zainahm3d/PDSupply-Solo-PCB/Front Render.png

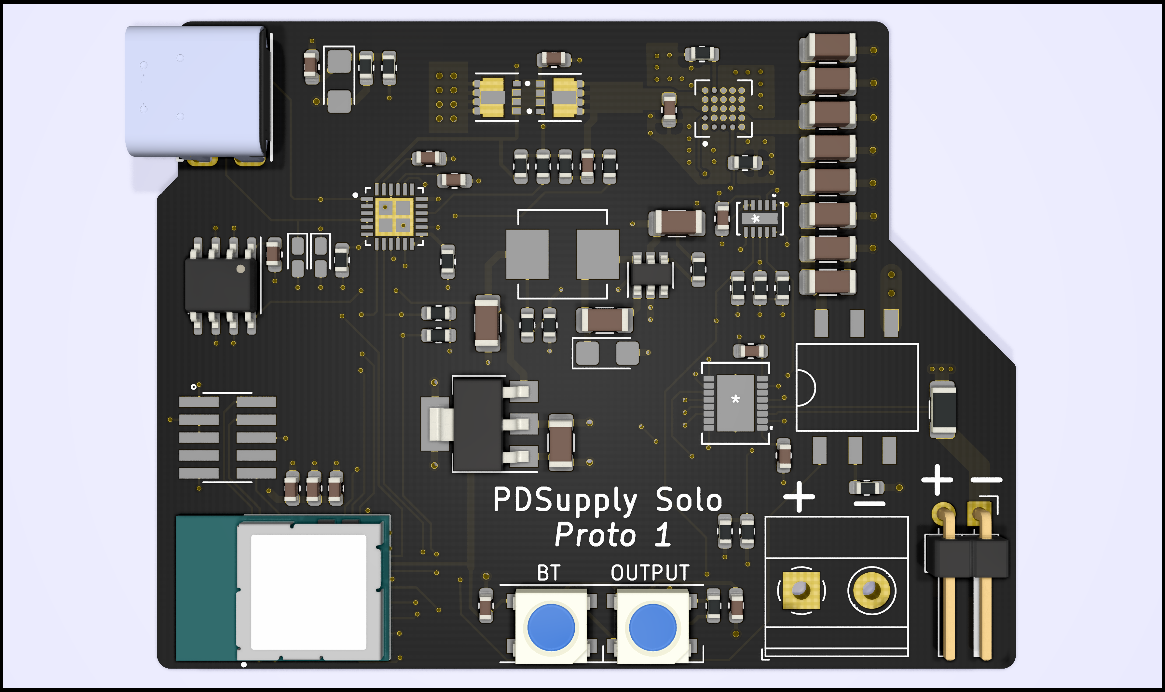
Front Render.png
