zainahm3d/PDSupply-Solo-PCB/Components/2020-05-08_21-34-57/NHR_16.step

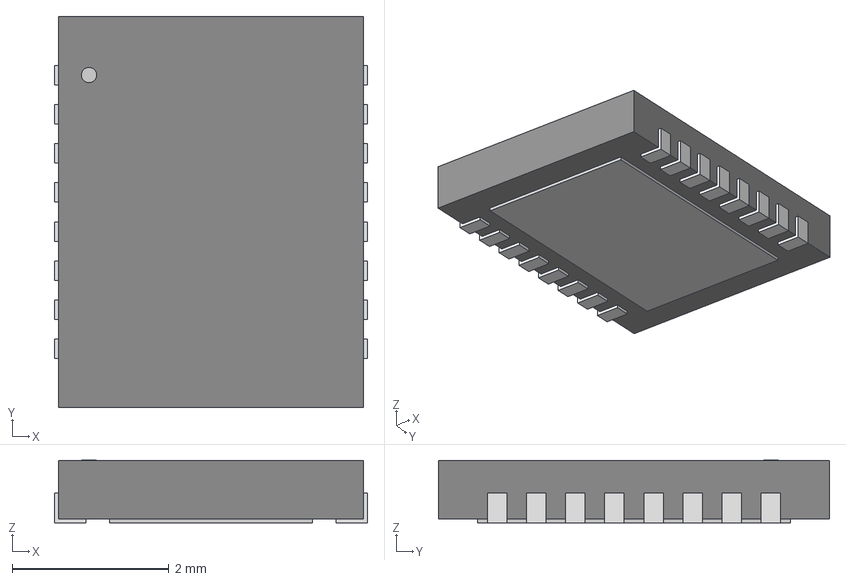
[picture p2: CAD file, 2020-06-15]
Components/2020-05-08_21-34-57/NHR_16.step
4.00 x 5.00 x 0.803 mm
