zainahm3d/PDSupply-Solo-PCB/Components/AQV252GAX/AQV252G2S_PAN-L.step

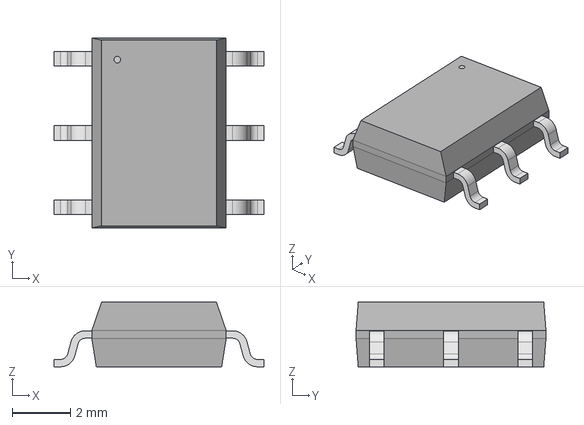
[picture p3: CAD file, 2020-06-15]
Components/AQV252GAX/AQV252G2S_PAN-L.step
7.19 x 6.50 x 2.21 mm
