zainahm3d/PDSupply-Solo-PCB/Components/FTSH-105-01-L-DV-K/FTSH-105-01-L-DV-K.stp

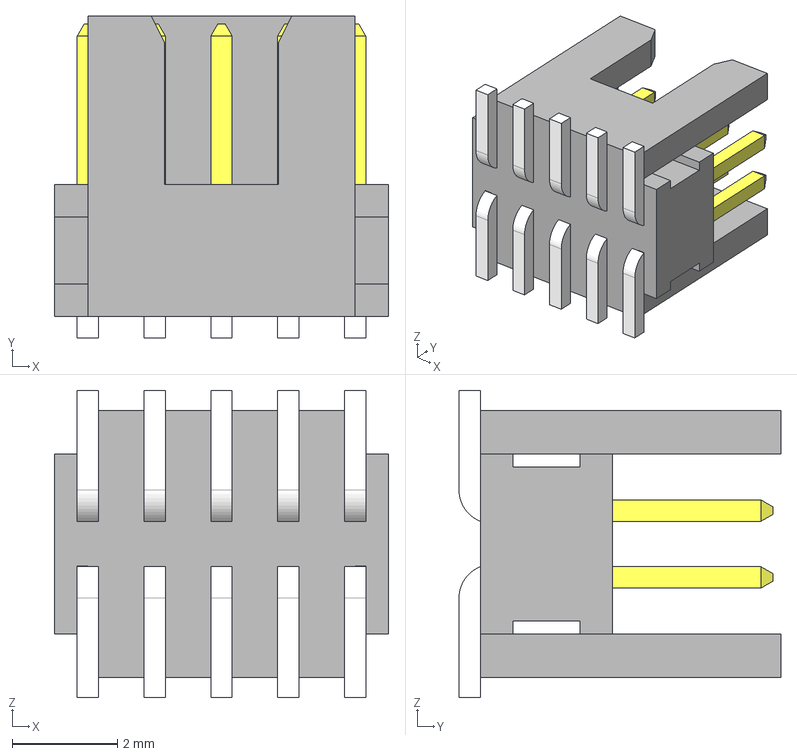
[picture p4: CAD file, 2020-06-15]
Components/FTSH-105-01-L-DV-K/FTSH-105-01-L-DV-K.stp
6.35 x 6.12 x 5.84 mm
_FTSH-105-01-L-DV-K_body
_FTSH-105-01-L-DV-K_pins1
_FTSH-105-01-L-DV-K_pins2
