zainahm3d/PDSupply-Solo-PCB/Components/LTC2644CMS-L10_PBF/MSOP-12_MS_LIT.step

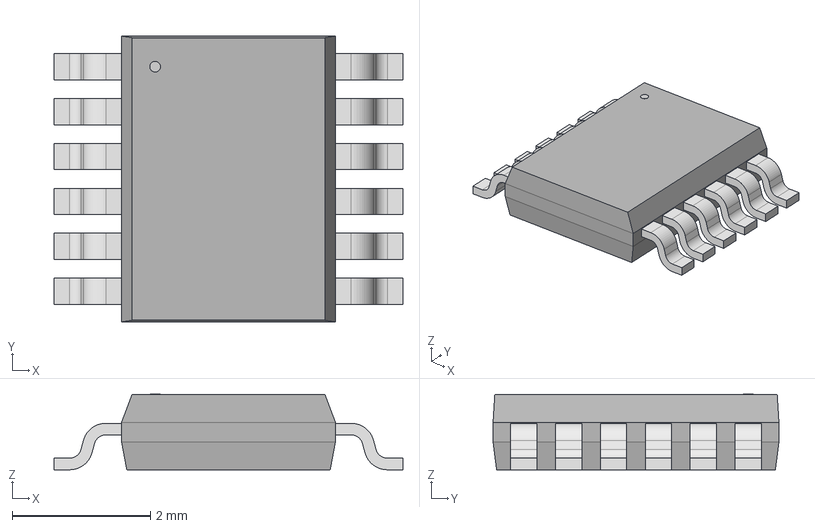
[picture p5: CAD file, 2020-06-15]
Components/LTC2644CMS-L10_PBF/MSOP-12_MS_LIT.step
5.05 x 4.14 x 1.09 mm
