zainahm3d/PDSupply-Solo-PCB/Components/LTM8074IY_PBF/BGA25_A.step

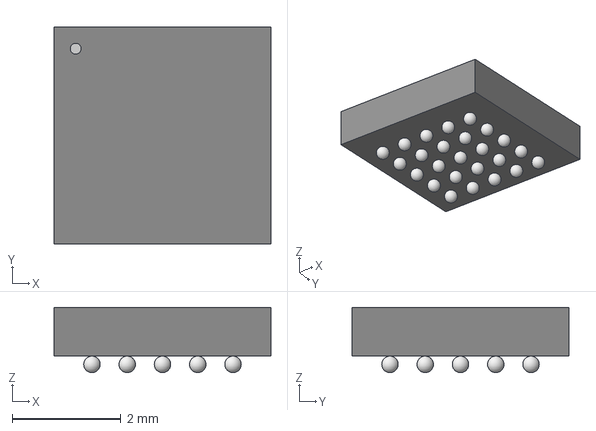
[picture p6: CAD file, 2020-06-15]
Components/LTM8074IY_PBF/BGA25_A.step
4.00 x 4.00 x 1.20 mm
