zainahm3d/PDSupply-Solo-PCB/Components/STUSB4500QTR/QFN24EP_4X4_STM.step

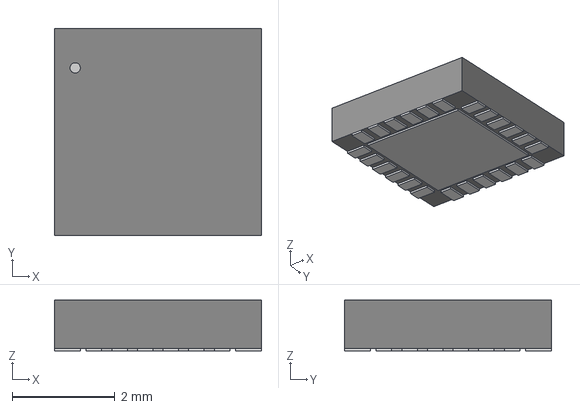
[picture p7: CAD file, 2020-06-15]
Components/STUSB4500QTR/QFN24EP_4X4_STM.step
4.04 x 4.04 x 0.993 mm
