zainahm3d/PDSupply-Solo-PCB/Components/ul_LTC3886EUKGPBF/2020-03-23_19-06-35/STEP/UKG_52-M.step

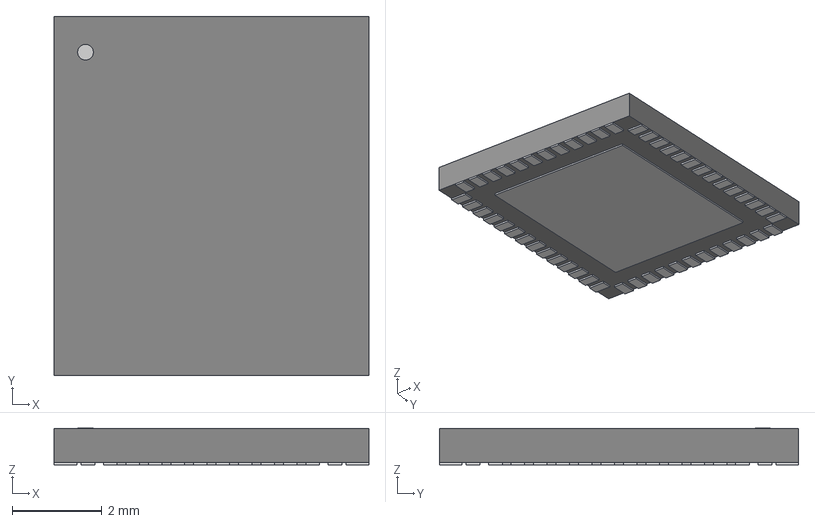
[picture p8: CAD file, 2020-03-23]
Components/ul_LTC3886EUKGPBF/2020-03-23_19-06-35/STEP/UKG_52-M.step
7.01 x 8.00 x 0.815 mm
