zainahm3d/PDSupply-Solo-PCB/(list of files, cad)

Other CAD files:
Components/ul_LTC3886EUKGPBF/2020-03-23_19-06-35/STEP/UKG_52.step
Components/ul_LTC3886EUKGPBF/2020-03-23_19-06-35/STEP/UKG_52-L.step
