zainahm3d/PDSupply-Solo-PCB/PD_PowerSupply.kicad_pcb

## KiCad design PD_PowerSupply.kicad_pcb (2022-03-03)

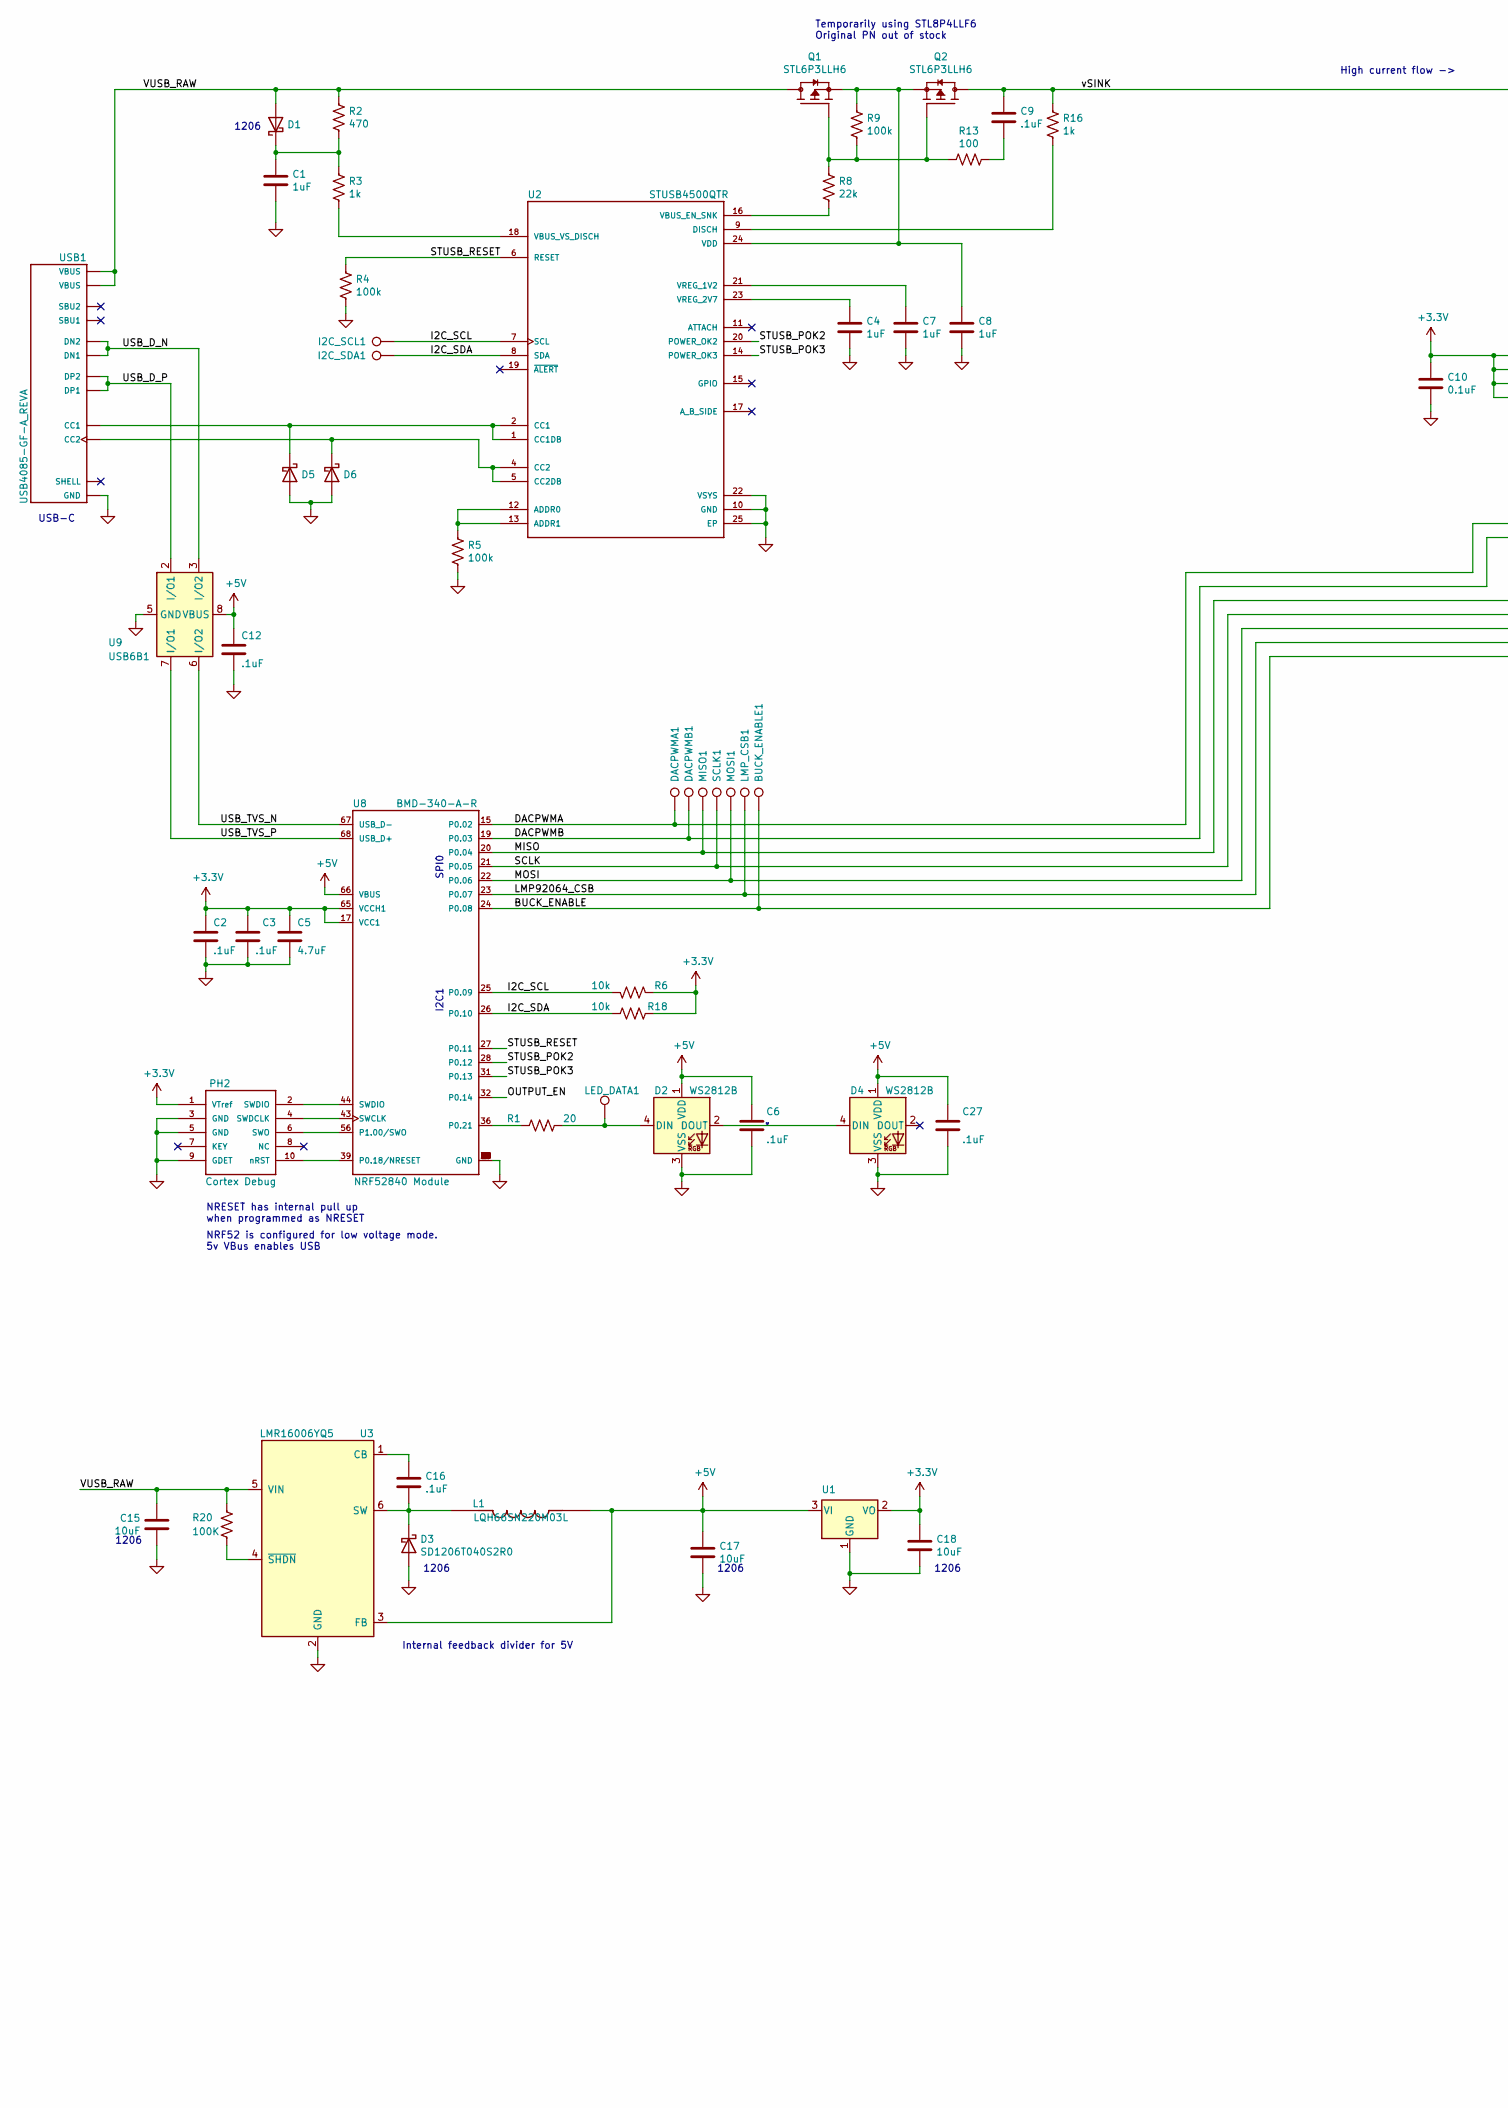
[picture p9: schematic PD_PowerSupply.sch, USB PD Power Supply, part in row 1, column 1]

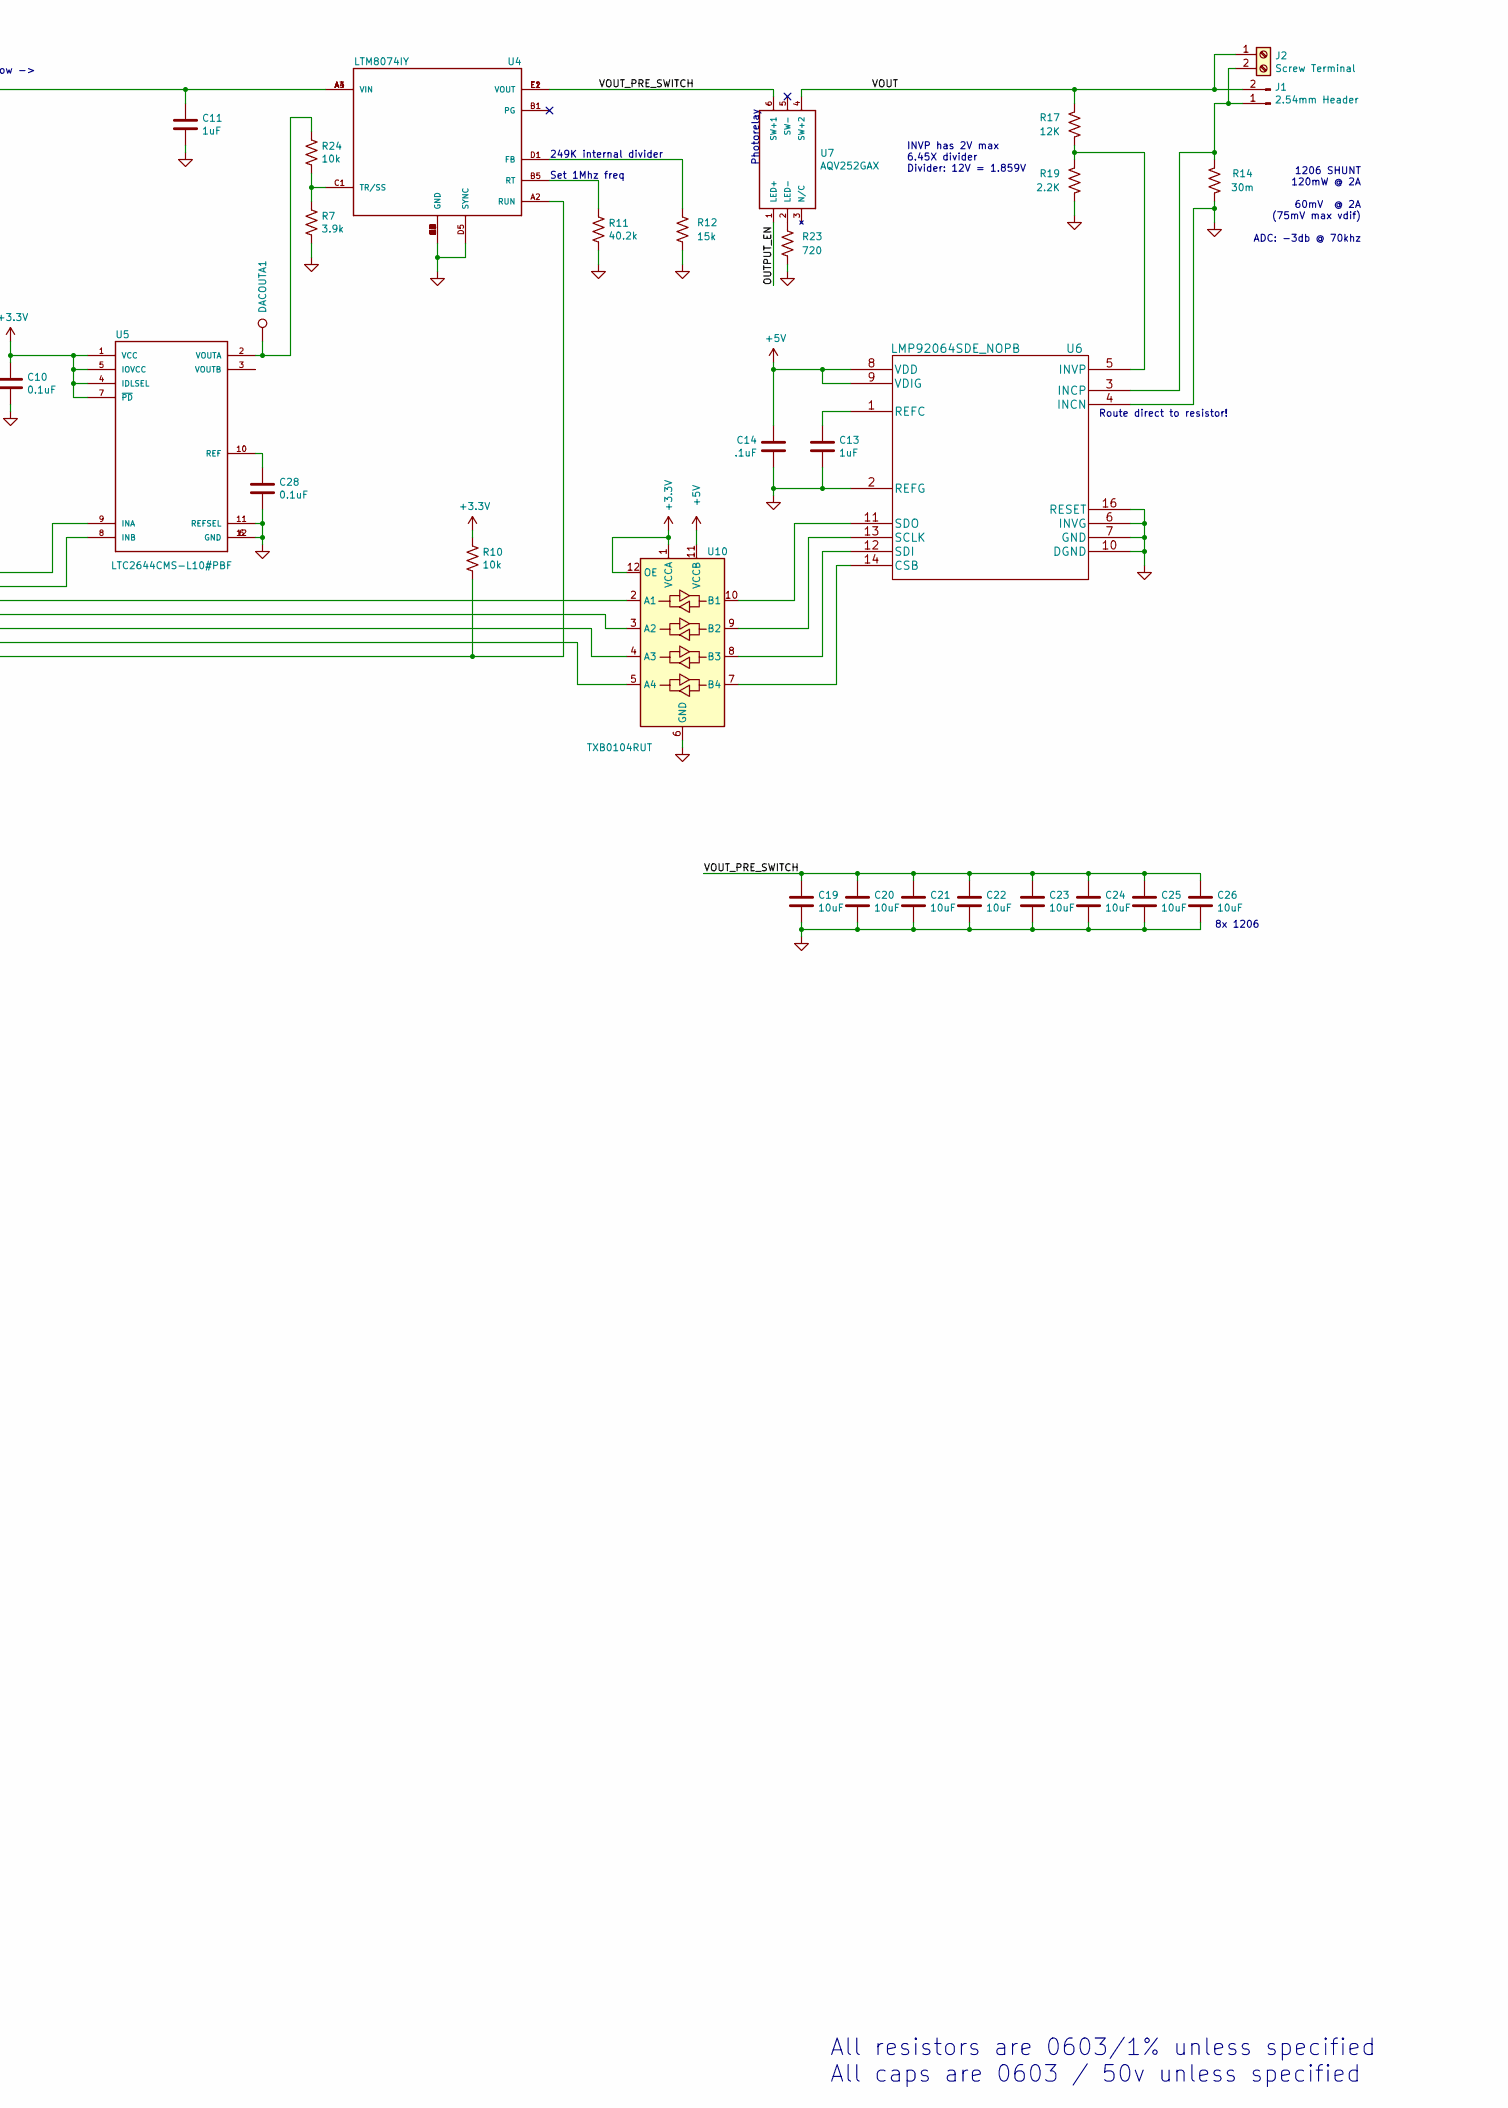
[picture p10: schematic PD_PowerSupply.sch, USB PD Power Supply, part in row 1, column 2]

Parts:
BUCK_ENABLE1: TestPoint; TestPoint_Pad_D1.0mm
C1, C4, C7, C8, C11, C13: 1uF; C_0603_1608Metric
C2, C3, C6, C9, C12, C14, C27: .1uF; C_0603_1608Metric
C5: 4.7uF; C_0603_1608Metric
C10, C28: 0.1uF; C_0603_1608Metric
C15, C17, C18, C19, C20, C21, C22, C23, C24, C25, C26: 10uF; C_1206_3216Metric
C16: .1uF; C_1206_3216Metric
D1: D_Schottky; D_1206_3216Metric_Castellated
D2, D4: WS2812B; LED_WS2812B_PLCC4_5.0x5.0mm_P3.2mm
D3: SD1206T040S2R0; D_1206_3216Metric_Castellated
D5, D6: D_Schottky; D_0603_1608Metric_Castellated
DACOUTA1: TestPoint; TestPoint_Pad_D1.0mm
DACPWMA1: TestPoint; TestPoint_Pad_D1.0mm
DACPWMB1: TestPoint; TestPoint_Pad_D1.0mm
I2C_SCL1, I2C_SDA1: TestPoint; TestPoint_Pad_D1.0mm
J1: 2.54mm Header; PinHeader_1x02_P2.54mm_Horizontal
J2: Screw Terminal; TerminalBlock_Phoenix_MKDS-1,5-2_1x02_P5.00mm_Horizontal
L1: LQH66SN220M03L; IND_LQH66SN220M03L
LED_DATA1: TestPoint; TestPoint_Pad_D1.0mm
LMP_CSB1: TestPoint; TestPoint_Pad_D1.0mm
MISO1: TestPoint; TestPoint_Pad_D1.0mm
MOSI1: TestPoint; TestPoint_Pad_D1.0mm
PH2: FTSH-105-01-L-DV-K; SAMTEC_FTSH-105-01-L-DV-K
Q1, Q2: STL6P3LLH6; TRANS_STL6P3LLH6
R1: 20; R_0603_1608Metric
R2: 470; R_0603_1608Metric
R3, R16: 1k; R_0603_1608Metric
R4, R5, R9: 100k; R_0603_1608Metric
R6, R10, R18, R24: 10k; R_0603_1608Metric
R7: 3.9k; R_0603_1608Metric
R8: 22k; R_0603_1608Metric
R11: 40.2k; R_0603_1608Metric
R12: 15k; R_0603_1608Metric
R13: 100; R_0603_1608Metric
R14: 30m; R_1206_3216Metric
R17: 12K; R_0603_1608Metric
R19: 2.2K; R_0603_1608Metric
R20: 100K; R_0603_1608Metric
R23: 720; R_0603_1608Metric
SCLK1: TestPoint; TestPoint_Pad_D1.0mm
U1: LM1117LD-3.3; SOT-223-3_TabPin2
U2: STUSB4500QTR; QFN50P400X400X90-25N
U3: LMR16006YQ5; SOT-23-6
U4: LTM8074IY; BGA25C65P5X5_400X400X198N
U5: LTC2644CMS-L10#PBF; SOP65P490X110-12N_LTC2644CMS-L10#PBF
U6: LMP92064SDE_NOPB; LMP92064SDE&slash_NOPB
U7: AQV252GAX; SOP6
U8: BMD-340-A-R; RIGADO_BMD-340-A-R
U9: USB6B1; SOIC-8_3.9x4.9mm_P1.27mm
U10: TXB0104RUT; Texas_R_PUQFN-N12
USB1: USB4085-GF-A_REVA; GCT_USB4085-GF-A_REVA

Connections:
+3V3: C2.1, C3.1, C5.1, C10.1, C18.1, PH2.1 (VTref), R6.1, R10.1, R18.1, U1.2 (VO), U5.1 (VCC), U5.4 (IDLSEL), U5.5 (IOVCC), U5.7 (~PD~), U8.17 (VCC1), U8.65 (VCCH1), U10.1 (VCCA), U10.12 (OE)
+5V: C6.1, C12.1, C14.1, C17.1, C27.1, D2.1 (VDD), D4.1 (VDD), L1.2, U1.3 (VI), U3.3 (FB), U6.8 (VDD), U6.9 (VDIG), U8.66 (VBUS), U9.1 (VBUS), U9.8 (VBUS), U10.11 (VCCB)
/BUCK_ENABLE: BUCK_ENABLE1.1, R10.2, U4.A2 (RUN), U8.24 (P0.08)
/DACPWMA: DACPWMA1.1, U5.9 (INA), U8.15 (P0.02)
/DACPWMB: DACPWMB1.1, U5.8 (INB), U8.19 (P0.03)
/I2C_SCL: I2C_SCL1.1, R6.2, U2.7 (SCL), U8.25 (P0.09)
/I2C_SDA: I2C_SDA1.1, R18.2, U2.8 (SDA), U8.26 (P0.10)
/LMP92064_CSB: LMP_CSB1.1, U8.23 (P0.07), U10.5 (A4)
/MISO: MISO1.1, U8.20 (P0.04), U10.2 (A1)
/MOSI: MOSI1.1, U8.22 (P0.06), U10.4 (A3)
/OUTPUT_EN: U7.1 (LED+), U8.32 (P0.14)
/SCLK: SCLK1.1, U8.21 (P0.05), U10.3 (A2)
/STUSB_POK2: U2.20 (POWER_OK2), U8.28 (P0.12)
/STUSB_POK3: U2.14 (POWER_OK3), U8.31 (P0.13)
/STUSB_RESET: R4.1, U2.6 (RESET), U8.27 (P0.11)
/USB_D_N: U9.3 (I/O2), USB1.A7 (DN1), USB1.B7 (DN2)
/USB_D_P: U9.2 (I/O1), USB1.A6 (DP1), USB1.B6 (DP2)
/USB_TVS_N: U8.67 (USB_D-), U9.6 (I/O2)
/USB_TVS_P: U8.68 (USB_D+), U9.7 (I/O1)
/VOUT: J1.2, J2.1, R17.1, U7.4 (SW+2)
/VOUT_PRE_SWITCH: C19.1, C20.1, C21.1, C22.1, C23.1, C24.1, C25.1, C26.1, U4.E1 (VOUT), U4.E2 (VOUT), U7.6 (SW+1)
/VUSB_RAW: C15.2, D1.2 (A), Q1.5_6_7_8 (D), R2.1, R20.1, U3.5 (VIN), USB1.A4 (VBUS), USB1.A9 (VBUS), USB1.B4 (VBUS), USB1.B9 (VBUS)
/vSINK: C9.1, C11.1, Q2.5_6_7_8 (D), R16.2, U4.A3 (VIN), U4.A4 (VIN)
GND: C1.2, C2.2, C3.2, C4.2, C5.2, C6.2, C7.2, C8.2, C10.2, C11.2, C12.2, C13.2, C14.2, C15.1, C17.2, C18.2, C19.2, C20.2, C21.2, C22.2, C23.2, C24.2, C25.2, C26.2, C27.2, C28.2, D2.3 (VSS), D3.2 (A), D4.3 (VSS), D5.2 (A), D6.2 (A), PH2.3 (GND), PH2.5 (GND), PH2.9 (GDET), R4.2, R5.2, R7.2, R11.2, R12.2, R14.2, R19.2, R23.2, U1.1 (GND), U2.10 (GND), U2.22 (VSYS), U2.25 (EP), U3.2 (GND), U4.A1 (GND), U4.A5 (GND), U4.B2 (GND), U4.B3 (GND), U4.B4 (GND), U4.C2 (GND), U4.C3 (GND), U4.C4 (GND), U4.C5 (GND), U4.D2 (GND), U4.D3 (GND), U4.D4 (GND), U4.D5 (SYNC), U4.E3 (GND), U4.E4 (GND), U4.E5 (GND), U5.6 (GND), U5.11 (REFSEL), U5.12 (GND), U6.2 (REFG), U6.4 (INCN), U6.6 (INVG), U6.7 (GND), U6.10 (DGND), U6.16 (RESET), U8.1 (GND), U8.2 (GND), U8.3 (GND), U8.4 (GND), U8.5 (GND), U8.16 (GND), U8.18 (GND), U8.29 (GND), U8.30 (GND), U8.45 (GND), U8.46 (GND), U8.47 (GND), U8.55 (GND), U9.4 (GND), U9.5 (GND), U10.6 (GND), USB1.A1 (GND), USB1.A12 (GND), USB1.B1 (GND), USB1.B12 (GND)
unnamed: C1.1, D1.1 (K), R2.2, R3.1
unnamed: C4.1, U2.23 (VREG_2V7)
unnamed: C7.1, U2.21 (VREG_1V2)
unnamed: C8.1, Q1.1 (S), Q1.2 (S), Q1.3 (S), Q2.1 (S), Q2.2 (S), Q2.3 (S), R9.1, U2.24 (VDD)
unnamed: C9.2, R13.1
unnamed: C13.1, U6.1 (REFC)
unnamed: C16.1, U3.1 (CB)
unnamed: C16.2, D3.1 (K), L1.1, U3.6 (SW)
unnamed: C28.1, U5.10 (REF)
unnamed: D2.2 (DOUT), D4.4 (DIN)
unnamed: D2.4 (DIN), LED_DATA1.1, R1.1
unnamed: D5.1 (K), U2.1 (CC1DB), U2.2 (CC1), USB1.A5 (CC1)
unnamed: D6.1 (K), U2.4 (CC2), U2.5 (CC2DB), USB1.B5 (CC2)
unnamed: DACOUTA1.1, R24.1, U5.2 (VOUTA)
unnamed: J1.1, J2.2, R14.1, U6.3 (INCP)
unnamed: PH2.2 (SWDIO), U8.44 (SWDIO)
unnamed: PH2.4 (SWDCLK), U8.43 (SWCLK)
unnamed: PH2.6 (SWO), U8.56 (P1.00/SWO)
unnamed: PH2.10 (nRST), U8.39 (P0.18/NRESET)
unnamed: Q1.4 (G), Q2.4 (G), R8.1, R9.2, R13.2
unnamed: R1.2, U8.36 (P0.21)
unnamed: R3.2, U2.18 (VBUS_VS_DISCH)
unnamed: R5.1, U2.12 (ADDR0), U2.13 (ADDR1)
unnamed: R8.2, U2.16 (VBUS_EN_SNK)
unnamed: R11.1, U4.B5 (RT)
unnamed: R12.1, U4.D1 (FB)
unnamed: R16.1, U2.9 (DISCH)
unnamed: R17.2, R19.1, U6.5 (INVP)
unnamed: R20.2, U3.4 (~SHDN)
unnamed: R23.1, U7.2 (LED-)
unnamed: R7.1, R24.2, U4.C1 (TR/SS)
unnamed: U6.14 (CSB), U10.7 (B4)
unnamed: U6.12 (SDI), U10.8 (B3)
unnamed: U6.13 (SCLK), U10.9 (B2)
unnamed: U6.11 (SDO), U10.10 (B1)
unnamed: USB1.P1 (SHELL), USB1.P2 (SHELL), USB1.P3 (SHELL), USB1.P4 (SHELL)

Notes on the sheet:
All resistors are 0603/1% unless specified All caps are 0603 / 50v unless specified
1206
High current flow ->
1206 SHUNT 120mW @ 2A 60mV @ 2A (75mV max vdif) ADC: -3db @ 70khz
INVP has 2V max 6.45X divider Divider: 12V = 1.859V
Route direct to resistor!
NRESET has internal pull up when programmed as NRESET
NRF52 is configured for low voltage mode. 5v VBus enables USB
SPI0
I2C1
8x 1206
249K internal divider
Set 1Mhz freq
lol
Photorelay
Temporarily using STL8P4LLF6 Original PN out of stock
Internal feedback divider for 5V
USB-C

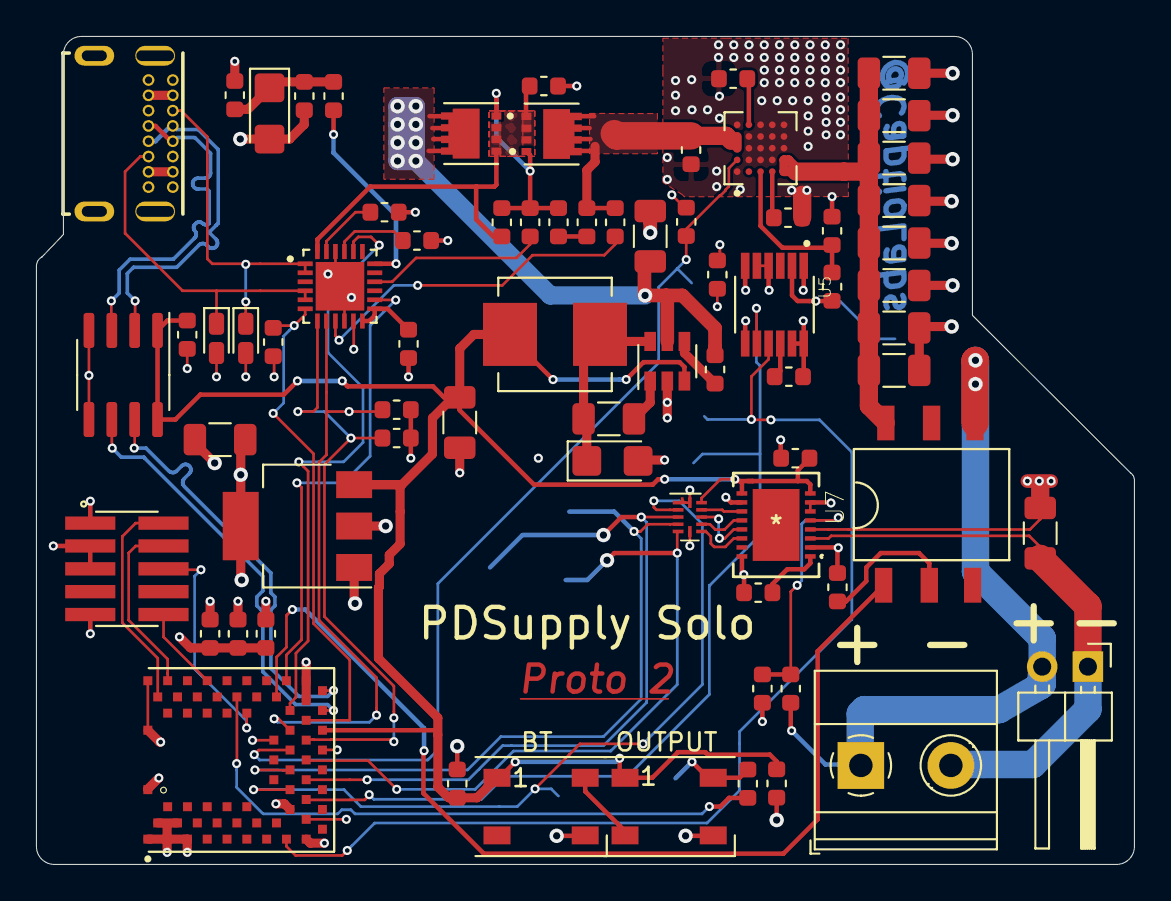
[picture p11: board PD_PowerSupply.kicad_pcb from above]

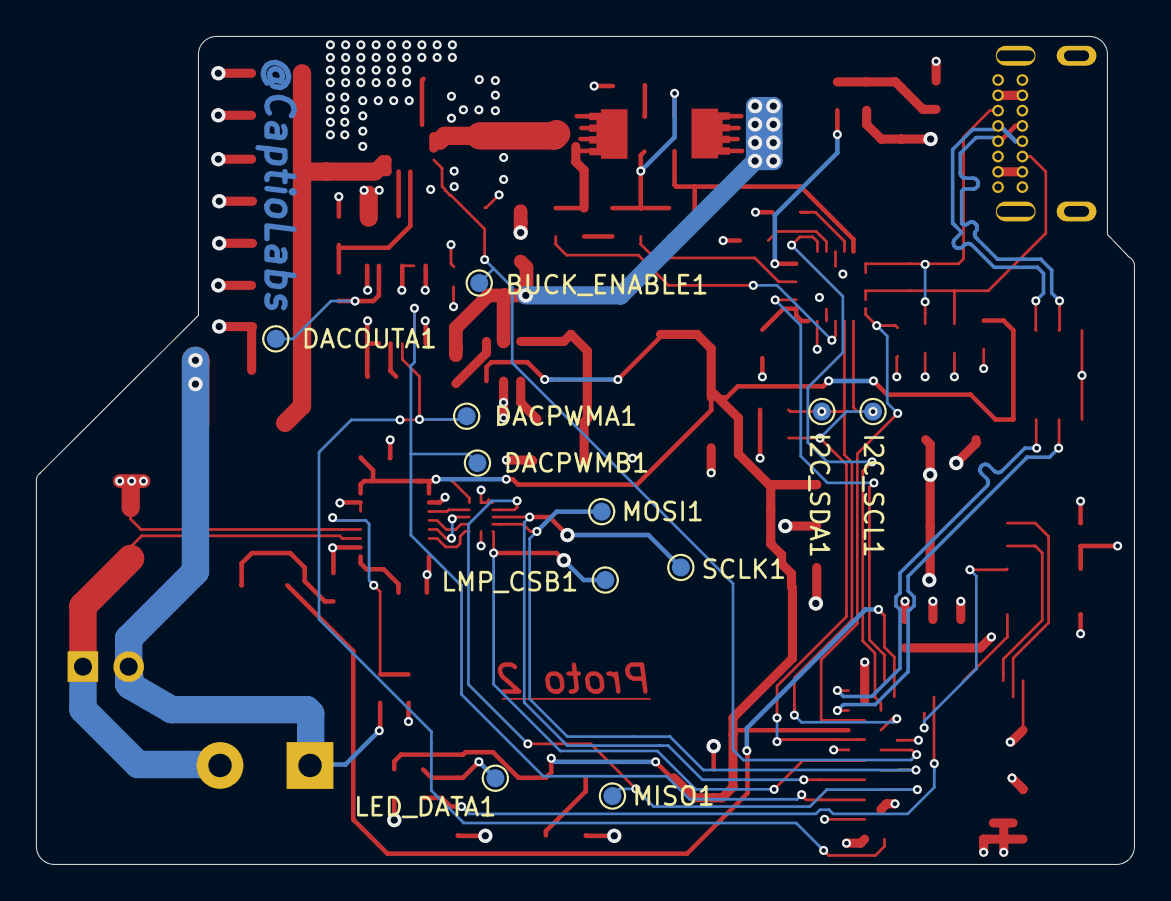
[picture p12: board PD_PowerSupply.kicad_pcb from below]

Board: 4 copper layers, 61.0 x 46.0 mm, 83 parts (11 on the bottom side), 60 nets.
