zainahm3d/PDSupply-Solo-PCB/(commit log)

2020-03-22 STUSB config done
    [PD_PowerSupply.kicad_pcb, PD_PowerSupply.sch]
2020-03-23 switched to linear chip
    [PD_PowerSupply.kicad_pcb, PD_PowerSupply.sch, UKG_52-L.step, UKG_52-M.step, UKG_52.step]
2020-03-23 switched to unswitched
    [PD_PowerSupply.kicad_pcb, PD_PowerSupply.sch]
2020-03-29 added footprints and symbol for LTC2972
    [PD_PowerSupply.kicad_pcb, PD_PowerSupply.sch]
2020-03-30 set up coprocessor
    [PD_PowerSupply.kicad_pcb, PD_PowerSupply.sch]
2020-04-03 integrated STM32 and assigned most footprints
    [PD_PowerSupply.kicad_pcb, PD_PowerSupply.sch]
2020-04-03 added debug and power out connectors
    [PD_PowerSupply.kicad_pcb, PD_PowerSupply.sch]
2020-04-03 added secondary 2.54 headers
    [PD_PowerSupply.kicad_pcb, PD_PowerSupply.sch]
2020-04-04 started routing switchers
    [PD_PowerSupply.kicad_pcb, PD_PowerSupply.sch]
2020-04-04 power stage in progress
    [PD_PowerSupply.kicad_pcb]
2020-04-05 power stage complete, STUSB in progress
    [PD_PowerSupply.kicad_pcb]
2020-04-05 STUSB in progress
    [PD_PowerSupply.kicad_pcb, PD_PowerSupply.sch]
2020-04-06 STM32 in progress
    [PD_PowerSupply.kicad_pcb]
2020-04-24 changed testpoints
    [PD_PowerSupply.sch]
2020-04-24 create single channel version w LTC7106-1 SPI DAC
    [PD_PowerSupply.kicad_pcb, PD_PowerSupply.sch]
2020-05-10 Setup LMP92064
    Wanted to avoid using the internal ADC in the nrf52
    [PD_PowerSupply.kicad_pcb, PD_PowerSupply.sch]
2020-05-10 Correct reference ground connection
    [PD_PowerSupply.sch]
2020-05-10 Added BMD-340 standalone NRF52840
    Low voltage mode + usb support
    [BMD-340-A-R--3DModel-STEP-56544.STEP, PD_PowerSupply.kicad_pcb, PD_PowerSupply.sch]
2020-05-10 add power rails, photorelay, bulk caps
    [PD_PowerSupply.kicad_pcb, PD_PowerSupply.sch]
2020-05-10 Filled voltage divider values
    [PD_PowerSupply.sch]
2020-05-11 set feedback resistance and noted vout accuracy
    [PD_PowerSupply.kicad_pcb, PD_PowerSupply.sch]
2020-05-16 Added USB protection diodes
    [PD_PowerSupply.sch]
2020-05-16 Added in capacitor for diode protection
    [PD_PowerSupply.kicad_pcb]
2020-05-26 Started routing process, swapped out photorelay for an SMD alternative
    [PD_PowerSupply.kicad_pcb]
2020-05-26 completed routing. Ready for eval.
    [PD_PowerSupply.kicad_pcb]
2020-05-27 Fixed DRC errors, moved silkscreen
    [PD_PowerSupply.kicad_pcb, PD_PowerSupply.sch]
2020-05-27 Setup fab drawing and remove designators from silk
    [PD_PowerSupply.kicad_pcb, PD_PowerSupply.sch]
2020-05-28 Generated gerbers, started BOM setup for PCBWay
    [PD_PowerSupply-B_Cu.gbr, PD_PowerSupply-B_Fab.gbr, PD_PowerSupply-B_Mask.gbr, PD_PowerSupply-B_Paste.gbr, PD_PowerSupply-B_SilkS.gbr, PD_PowerSupply-Cmts_User.gbr, PD_PowerSupply-Dwgs_User.gbr, PD_PowerSupply-Eco1_User.gbr]
2020-05-29 Generate gerbers, drill, centroid, and BOM
    [PD_PowerSupply-B_Cu.gbr, PD_PowerSupply-B_Fab.gbr, PD_PowerSupply-B_Mask.gbr, PD_PowerSupply-B_Paste.gbr, PD_PowerSupply-B_SilkS.gbr, PD_PowerSupply-Cmts_User.gbr, PD_PowerSupply-Dwgs_User.gbr, PD_PowerSupply-Eco1_User.gbr]
2020-05-29 Regenerate Gerbers
    [PD_PowerSupply-B_Cu.gbr, PD_PowerSupply-B_Fab.gbr, PD_PowerSupply-B_Mask.gbr, PD_PowerSupply-B_Paste.gbr, PD_PowerSupply-B_SilkS.gbr, PD_PowerSupply-Cmts_User.gbr, PD_PowerSupply-Dwgs_User.gbr, PD_PowerSupply-Eco1_User.gbr]
2020-06-15 Switched to PWM DAC
    [AQV252G2S_PAN-L.step, BGA25_A.step, FTSH-105-01-L-DV-K.stp, LQH66S.STEP, MSOP-12_MS_LIT.step, NHR_16.step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]
2020-06-18 Added level shifter for ADC
    [PD_PowerSupply-B_Cu.gbr, PD_PowerSupply-B_Fab.gbr, PD_PowerSupply-B_Mask.gbr, PD_PowerSupply-B_Paste.gbr, PD_PowerSupply-B_SilkS.gbr, PD_PowerSupply-Cmts_User.gbr, PD_PowerSupply-Dwgs_User.gbr, PD_PowerSupply-Eco1_User.gbr]
2020-06-18 Added missing SPI test points (oops)
    [PD_PowerSupply-B_Cu.gbr, PD_PowerSupply-B_Fab.gbr, PD_PowerSupply-B_Mask.gbr, PD_PowerSupply-B_Paste.gbr, PD_PowerSupply-B_SilkS.gbr, PD_PowerSupply-Cmts_User.gbr, PD_PowerSupply-Dwgs_User.gbr, PD_PowerSupply-Eco1_User.gbr]
2020-08-13 after testing, removed FB resistors and backup PWM DAC channel
    [PD_PowerSupply.kicad_pcb, PD_PowerSupply.sch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]
2020-10-17 remove feedback divider from 5V buck (internal divider)
    [BMD-340-A-R--3DModel-STEP-56544.STEP, LQH66S.STEP, PD_PowerSupply.kicad_pcb, PD_PowerSupply.sch, PD_PowerSupply_BOM.xlsx, STL3N65M2.STEP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]
2022-03-03 [WIP] fixing voltage leakage on USB C port
    [PD_PowerSupply.kicad_pcb]
