zainahm3d/PDSupply-Solo-PCB/(notices)

Notices in the files:
Components/FTSH-105-01-L-DV-K/FTSH-105-01-L-DV-K.stp:
FILE_NAME( 'p:/temp/worker_175/temp/exporttempdir_3540_161_iclgV/format_0/FTSH-105-01-L-DV-K.stp', '2020-06-14T17:40:26', ( 'License CC BY-ND 4.0' ), ( 'CADENAS' ), ' ', 'PARTsolutions', ' ' );
